tedyapo/tritiled/docs/images/tritiled30_photo.jpg

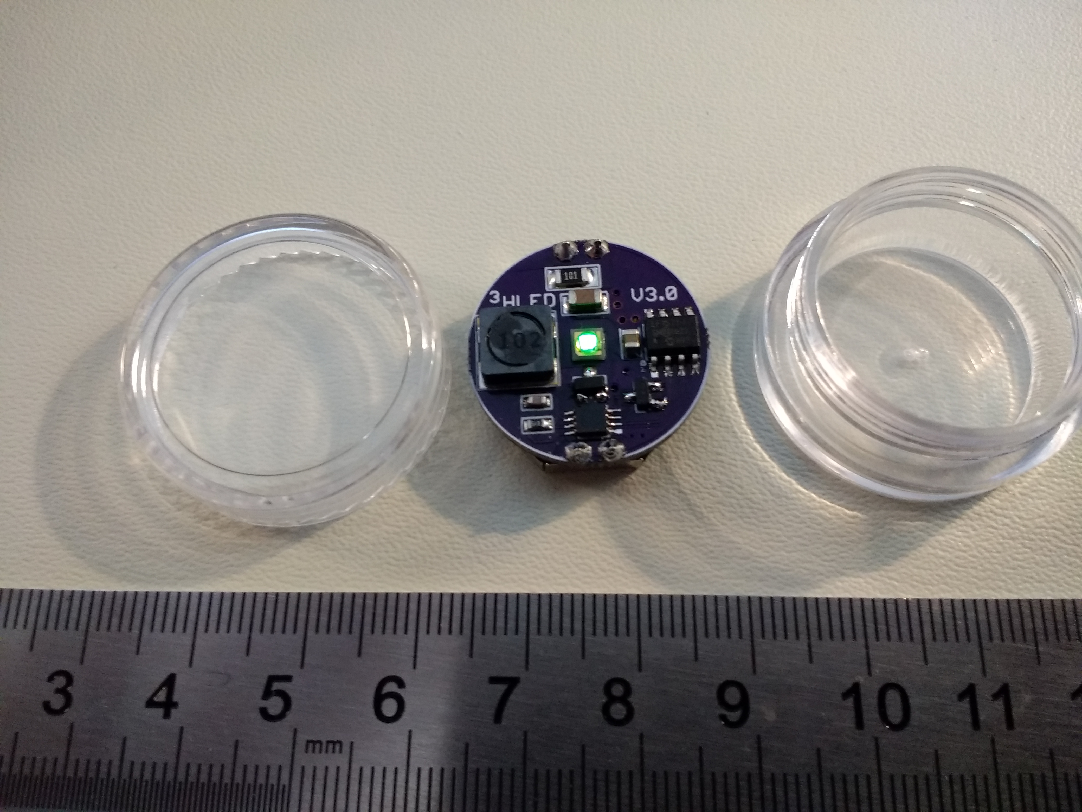
docs/images/tritiled30_photo.jpg
