tedyapo/tritiled/mechanical/tritiled2x_case/tritiled_v22_case.stl

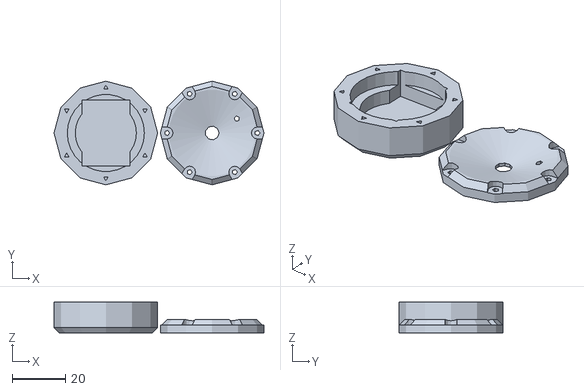
[picture p10: CAD file, 2017-07-12]
mechanical/tritiled2x_case/tritiled_v22_case.stl
79.0 x 39.0 x 11.6
