tedyapo/tritiled/(threads)

Thread 8 (2017-07-27):

Create smaller case for V2.2

tedyapo, 2017-07-27:
Current case design is bulky and required (6) screws.  Make a smaller, more attractive one.

tedyapo, 2018-01-13:
V3.x has a nice case

Closed 2018-01-13.

Thread 10 (2017-08-16):

Power-saving ("off") mode for V2.2

tedyapo, 2017-08-16:
Implement software-only off mode which sleeps until button is pressed to conserve battery; this should be a separate, optional build for those who want such functionality.

tedyapo, 2018-01-13:
power is low enough.  remove battery for real power-off

Closed 2018-01-13.

Thread 33 (2022-09-23):

regenerative snubber

Ozzy33, 2022-09-23:
Hi Ted, awesome project!
Sorry about posting here, at hackaday you didn't seem to respond.
You ever think about a regenerative snubber for the wasted ring energy after LED current has stopped (the drain ringing energy)?
It could add some time to your project? Or are you done with this project?
I will delete this post if your not interested.
TIA!

Thread 36 (2023-10-11):

The interface issue

tedmalonos, 2023-10-11:
The problem in the interface. Just opened the KiCad 7.0 and have this kind of issue, the same problem in every editor.

Don`t know what to do, maube someone knows what to do?

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

Thread 37 (2023-11-10):

How to reduce flickering?

gcormier, 2023-11-10:
I'm trying to get rid of flicker which happens in the lower half of the brightness options for my specific hardware.

I've been trying fairly unsuccessfully to make this happen in software. The closest I've gotten is setting PWM1 phase to 2, which then makes everything really really dim. Which is almost what I want, but then really cuts down on the range I can choose.

Any tips on how to do so would be apprieciated.

tedyapo, 2023-11-10:
i'm assuming this is V2.x hardware? flicker is related to the flash rate. the overall current draw is proportional to the flash rate and the energy per flash; so generally, you get a lower flash rate and more visible flicker with lower overall current draw and extended runtime.

you won't have much luck in software; you can only change the flash rate there.

what you need to do is change the pulse width, which is set by the '123 one-shot. the R and C in the published BoM were chosen to create a pulse width that translates into a current pulse close to the peak LED efficiency. if you reduce the R, you can generate a shorter pulse, which will generate a dimmer and shorter LED pulse. this will allow you to turn up the blink frequency, reducing flicker, while still maintaining a lower current draw.

you will lose a little bit of efficiency here for two reasons. first, you won't be driving the LED near the peak efficiency current. but, take a close look at the LED efficiency curves -- you can cut the LED current in half or more without effecting the efficiency that much. that will let you drive it with more than twice the frequency, reducing flicker. the second efficiency loss is larger, and that is due to the overhead of waking up the PIC and generating the pulse for each flash. if you crank up the frequency to reduce flicker, you'll be losing more efficiency to this overhead. there isn't much you can do about this.

so, my recipe for reducing flicker at lower current draw is to reduce R3 in the V2.x circuit. this will decrease the pulse width and the peak LED current. once this is done, you can increase the pulse rate in software, and the flicker will be reduced. if you want accurate run-time estimates, you'll need to calibrate the current draw.

my suggestion would be to solder a through-hole resistor on the board in place of R3. use long leads for testing. once you find a resistor that gives you the flicker vs current draw you like, you can solder on an SMD resistor permanently. i might try a value of half the initial R3 value as a start. then, play with flicker frequency, either by running the calibration code and python script, or just tweaking the pulse frequency table to your liking. you might want/need to go up or down in resistor value from there.

if you really want to be scientific about it, leave one copy of the circuit as-is, and use it as a comparison reference. at these light levels, it's easy to fool yourself, especially if the changes are somewhat subtle.

i think this is all i got, but i'm going to leave this issue open for a bit because i'm interested to see where you get with this. good luck!

gcormier, 2023-11-10:
Hey Ted! Awesome, thanks so much for the response :) I did not expect one.

As I'm using SMD, I might try to figure out a bodge by solering a resistor on top of the existing one to reduce the resistance. Yay, 0402's! :)

I was going to possibly redesign this at the expense of efficiency. I'll try to take some measurements once I find a very-dim option. Ditching the monostable was what I was eyeing, and I noticed the everled fork with an Attiny13A which can approach 1uA standby. This would be taking a step towards your V2.0 I believe which is just a mosfet controlled directly by a GPIO.

For now, I have 18 of these to play with and fix up in time for Christmas presents. I will definitely report back!

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

gcormier, 2023-11-11:
It works!

I am down to 2.5K on R3. I'm using 1 mH inductor and the Cree XPEBGR-L1-0000-00F02 LED.

I will order some 1K resistors to see how low I can go.

I would love to optimize the BOM slightly, the LED is the biggest contributor to cost. I guess it's the price to pay as the brighter LED's translate to higher efficiency/savings at low power?

My use case is for nighttime to prevent smashing into something in the bedroom. Will make great gifts!

tedyapo, 2023-11-12:
cool. what frequency are you running them at, and what's the current draw? if you can put a scope on the led/inductor, i'd be very interested to see the waveform there. the current pulses must be very short and low

gcormier, 2023-11-12:
Here's my `modes.h`. Basically, your firmware setting 5 became my dimmest setting 10, as I found 4 and under on yours would be blinking.

```
#define N_MODES 10
struct run_time period_table[N_MODES] = {
  {1, (int)(31000./762.124721 + 0.5)},
  {2, (int)(31000./662.124721 + 0.5)},
  {3, (int)(31000./562.124721 + 0.5)},
  {4, (int)(31000./462.124721 + 0.5)},
  {5, (int)(31000./362.124721 + 0.5)},

  {6, (int)(31000./262.124721 + 0.5)},
  {7, (int)(31000./124.768381 + 0.5)},
  {8, (int)(31000./78.982934 + 0.5)},
  {9, (int)(31000./56.090211 + 0.5)},
  {10, (int)(31000./42.354577 + 0.5)},
};
```

I've got a 1K resistor for R3 now and I think that's what I will go with.

gcormier, 2023-11-29:
Here's the scope output

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

gcormier, 2025-05-14:
18 months in and still working off a **CR1225**! My first batch I picked the wrong footprint :)

Just put together 20 more with the proper batteries and updated my repository and instructions - https://github.com/gcormier/kitritiled

They make great little gifts!

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

tedyapo, 2025-05-15:
fantastic! i went the other way with a design: eliminating parts for cost-reduction and making it easier to assemble by hand. it's the 2.x circuit, but using the PWM peripheral wake from sleep for each pulse. it allows a much finer-grained adjustment than the WDT as used in the previous 2.x versions. i haven't documented it yet, of course

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

gcormier, 2025-05-18:
Very cool! Would love to see more if you ever share it!

Thread 38 (2024-06-01):

Universal footprint for LEDs

tort32, 2024-06-01:
Hello. Thank you for the great project.

I have minor PCB optimizations for various LED footprints:
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

This design also suitable for a single-side homebrewed PCBs.

Please see https://oshwlab.com/tort.biz/tritiled
