tedyapo/tritiled/hardware/eagle/V3/tritiled_v31_xpe.brd

## EAGLE design hardware/eagle/V3/tritiled_v31_xpe.brd (2018-01-09)

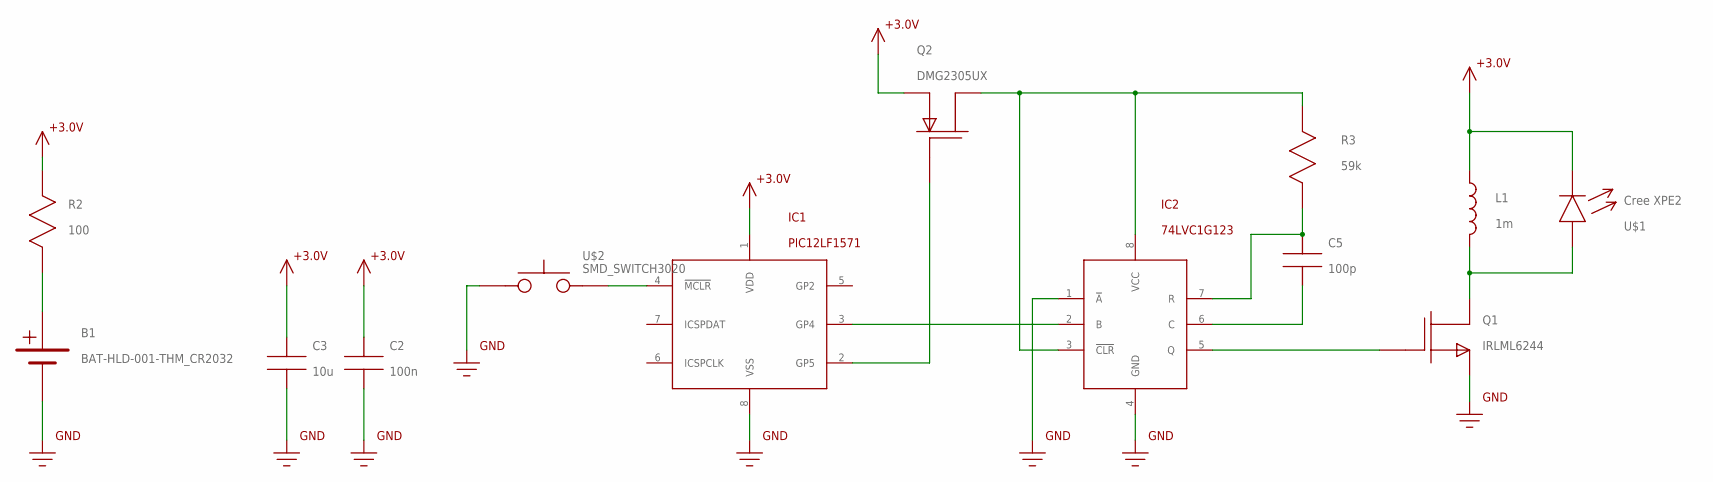
[picture p11: schematic tritiled_v31_xpe.sch]

Parts:
B1: BAT-HLD-001-THM_CR2032; CR2032_BAT-HLD-001-THM
C2: 100n; 0805
C3: 10u; 1206
C5: 100p; C0603
IC1: PIC12LF1571; SOIC8
IC2: 74LVC1G123; SM8
L1: 1m; SRR6028_INDUCTOR
Q1: IRLML6244; SOT-23
Q2: DMG2305UX; SOT-23
R2: 100; R1206
R3: 59k; R0603
U$1: Cree XPE2; CREE_XPE_LED
U$2: SMD_SWITCH3020; SWITCH_3020

Connections:
+3.6V: C2.P$1, C3.P$1, IC1.1 (VDD), L1.P$1 (1), Q2.2 (S), R2.P$1, U$1.C
GND: B1.GND (0V), C2.P$2, C3.P$2, IC1.8 (VSS), IC2.1 (!A!), IC2.4 (GND), Q1.2 (S), U$2.A
unnamed: C5.P$1, IC2.7 (R), R3.P$1
unnamed: IC2.5 (Q), Q1.1 (G)
unnamed: IC1.2 (GP5), Q2.1 (G)
unnamed: IC1.3 (GP4), IC2.2 (B)
unnamed: C5.P$2, IC2.6 (C)
unnamed: IC1.4 (!MCLR!), U$2.B
unnamed: IC2.3 (!CLR!), IC2.8 (VCC), Q2.3 (D), R3.P$2
unnamed: B1.+V@1 (+V), B1.+V@2 (+V), B1.+V@3 (+V), B1.+V@4 (+V), R2.P$2
unnamed: L1.P$2 (2), Q1.3 (D), U$1.A

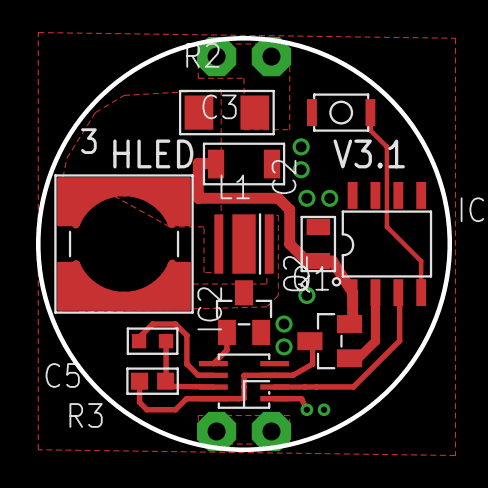
[picture p12: board tritiled_v31_xpe.brd from above]

Board: 2 copper layers, 22.9 x 22.9 mm, 13 parts (1 on the bottom side), 11 nets.
