tedyapo/tritiled/hardware/eagle/V3/tritiled_v30_batt_pcb.brd

## EAGLE design hardware/eagle/V3/tritiled_v30_batt_pcb.brd (2017-12-30)

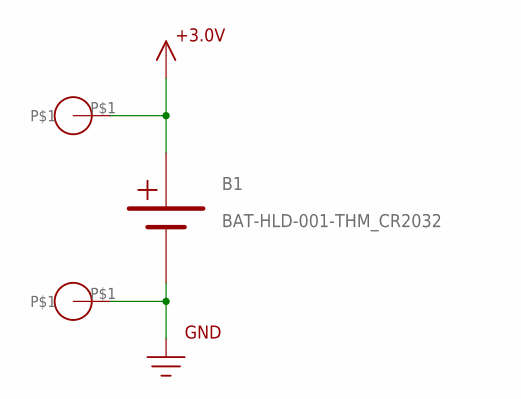
[picture p13: schematic tritiled_v30_batt_pcb.sch]

Parts:
B1: BAT-HLD-001-THM_CR2032; CR2032_BAT-HLD-001-THM
U$1, U$2: HDR_1_PIN

Connections:
+3.6V: B1.+V@1 (+V), B1.+V@2 (+V), B1.+V@3 (+V), B1.+V@4 (+V), U$1.P$1
GND: B1.GND (0V), U$2.P$1

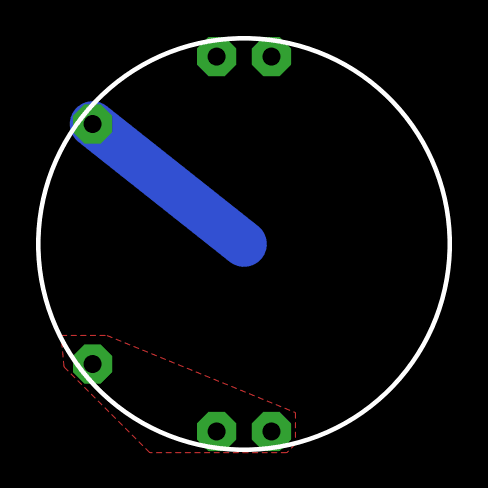
[picture p14: board tritiled_v30_batt_pcb.brd from above]

Board: 2 copper layers, 22.9 x 22.9 mm, 3 parts (1 on the bottom side), 2 nets.
