tedyapo/tritiled/hardware/eagle/V2/tritiled22_5630.brd

## EAGLE design hardware/eagle/V2/tritiled22_5630.brd (2017-08-16, an earlier design)

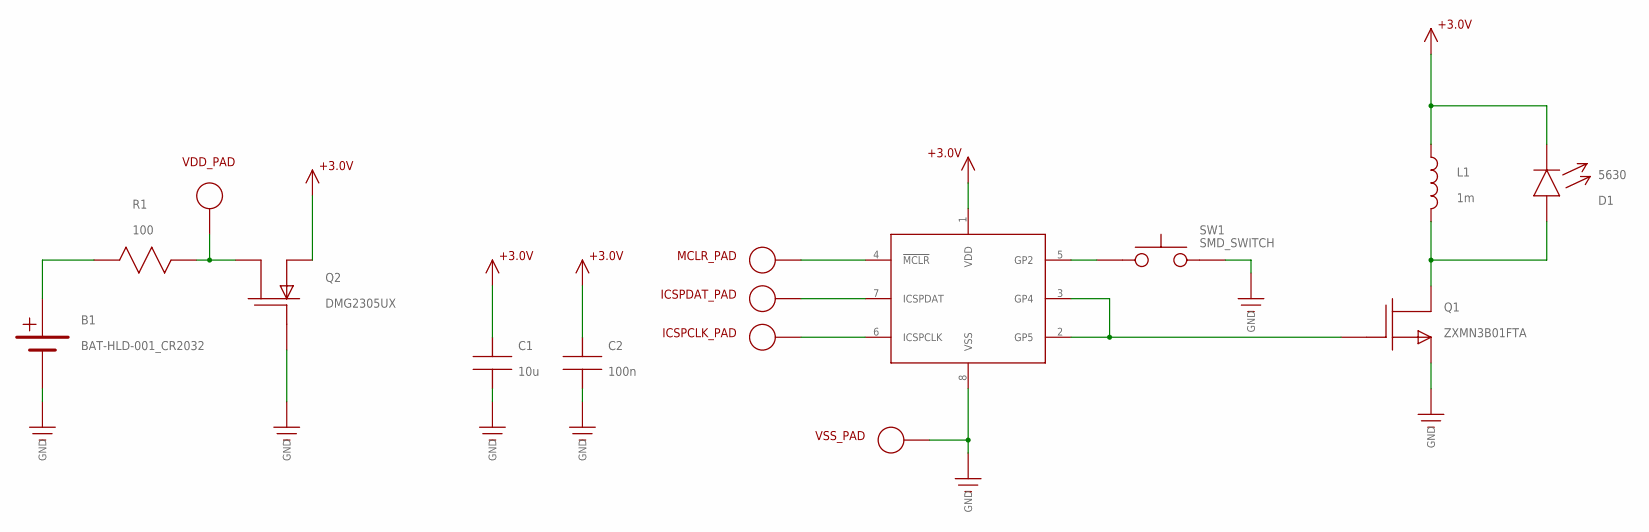
[picture p15: schematic tritiled22_5630.sch]

Parts:
B1: BAT-HLD-001_CR2032; CR2032_BAT-HLD_001
C1: 10u; 1206
C2: 100n; 0805
D1: 5630; LED_5630
ICSPCLK_PAD: ICSP_PAD
ICSPDAT_PAD: ICSP_PAD
L1: 1m; SRR6028_INDUCTOR
MCLR_PAD: ICSP_PAD
Q1: ZXMN3B01FTA; SOT-23
Q2: DMG2305UX; SOT-23
R1: 100; R1206
SW1: SMD_SWITCH
U1: PIC12LF1571; SOIC8
VDD_PAD: ICSP_PAD
VSS_PAD: ICSP_PAD

Connections:
+3.3V: C1.P$1, C2.P$1, D1.C@1 (C), D1.C@2 (C), L1.P$1 (1), Q2.2 (S), U1.1 (VDD)
GND: B1.GND (0V), C1.P$2, C2.P$2, Q1.2 (S), Q2.1 (G), SW1.P$3, SW1.P$4, U1.8 (VSS), VSS_PAD.P$2
unnamed: MCLR_PAD.P$2, U1.4 (!MCLR!)
unnamed: ICSPDAT_PAD.P$2, U1.7 (ICSPDAT)
unnamed: ICSPCLK_PAD.P$2, U1.6 (ICSPCLK)
unnamed: D1.A@1 (A), D1.A@2 (A), L1.P$2 (2), Q1.3 (D)
unnamed: SW1.P$1, SW1.P$2, U1.5 (GP2)
unnamed: Q1.1 (G), U1.2 (GP5), U1.3 (GP4)
VBATT: B1.+V1 (+V), B1.+V2 (+V), R1.P$1
VSAFE: Q2.3 (D), R1.P$2, VDD_PAD.P$2

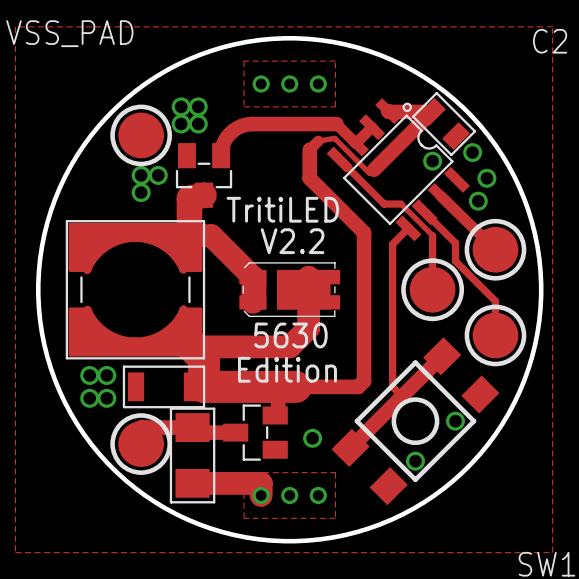
[picture p16: board tritiled22_5630.brd from above]

Board: 2 copper layers, 27.9 x 27.9 mm, 15 parts (1 on the bottom side), 10 nets.
