tedyapo/tritiled/hardware/eagle/V2/tritiled22_cr2477.brd

## EAGLE design hardware/eagle/V2/tritiled22_cr2477.brd (2017-12-18, an earlier design)

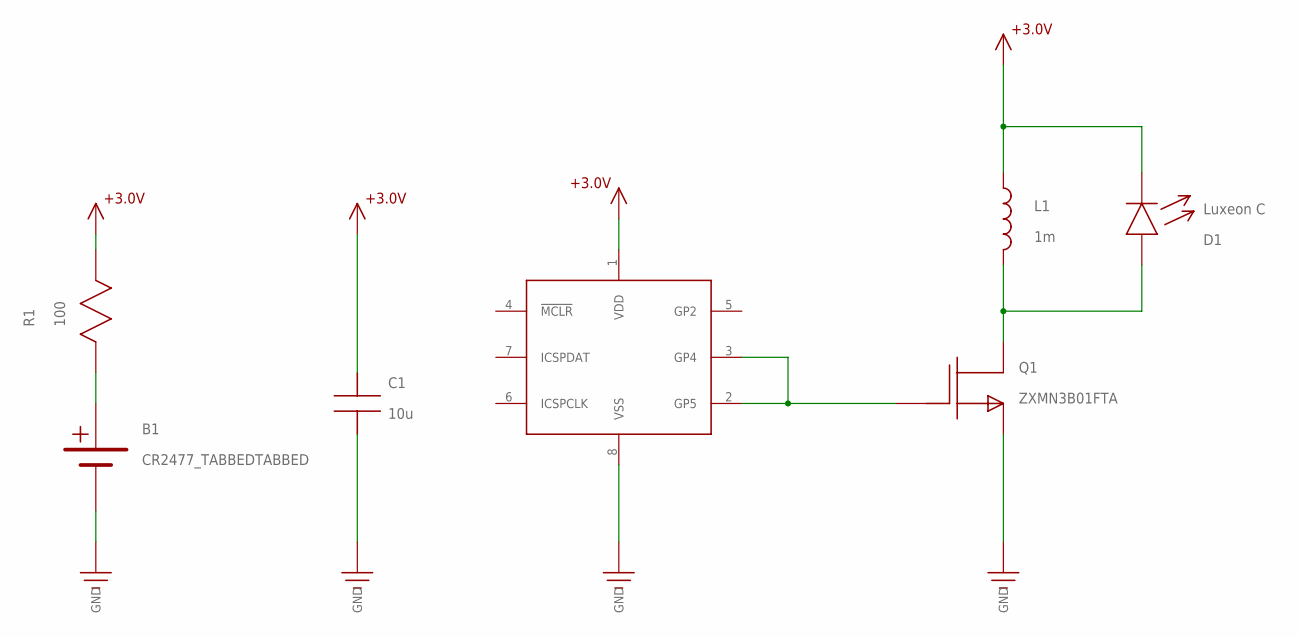
[picture p17: schematic tritiled22_cr2477.sch]

Parts:
B1: CR2477_TABBEDTABBED; CR2477_TABBED
C1: 10u; 1206
D1: Luxeon C; LUXEON_C
L1: 1m; SRR6028_INDUCTOR
Q1: ZXMN3B01FTA; SOT-23
R1: 100; R1206
U1: PIC12LF1571; SOIC8

Connections:
+3.3V: C1.P$1, D1.C, L1.P$1 (1), R1.P$2, U1.1 (VDD)
GND: B1.GND (0V), C1.P$2, Q1.2 (S), U1.8 (VSS)
unnamed: D1.A, L1.P$2 (2), Q1.3 (D)
unnamed: Q1.1 (G), U1.2 (GP5), U1.3 (GP4)
VBATT: B1.+3V (+V), R1.P$1

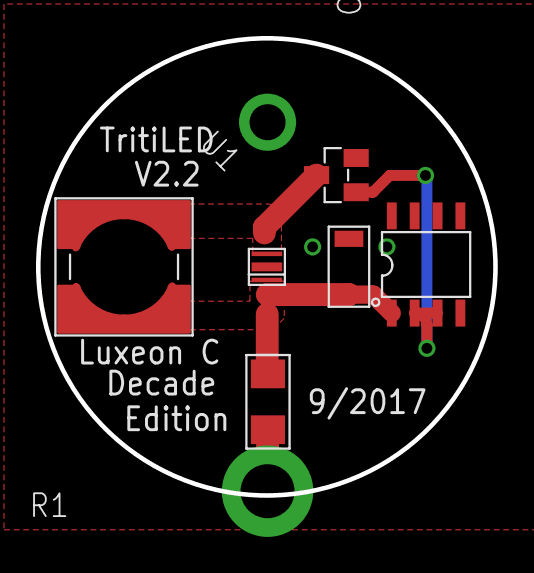
[picture p18: board tritiled22_cr2477.brd from above]

Board: 2 copper layers, 25.4 x 25.4 mm, 7 parts (1 on the bottom side), 5 nets.
