tedyapo/tritiled/hardware/eagle/V2/tritiled_module.brd

## EAGLE design hardware/eagle/V2/tritiled_module.brd (2017-12-18, an earlier design)

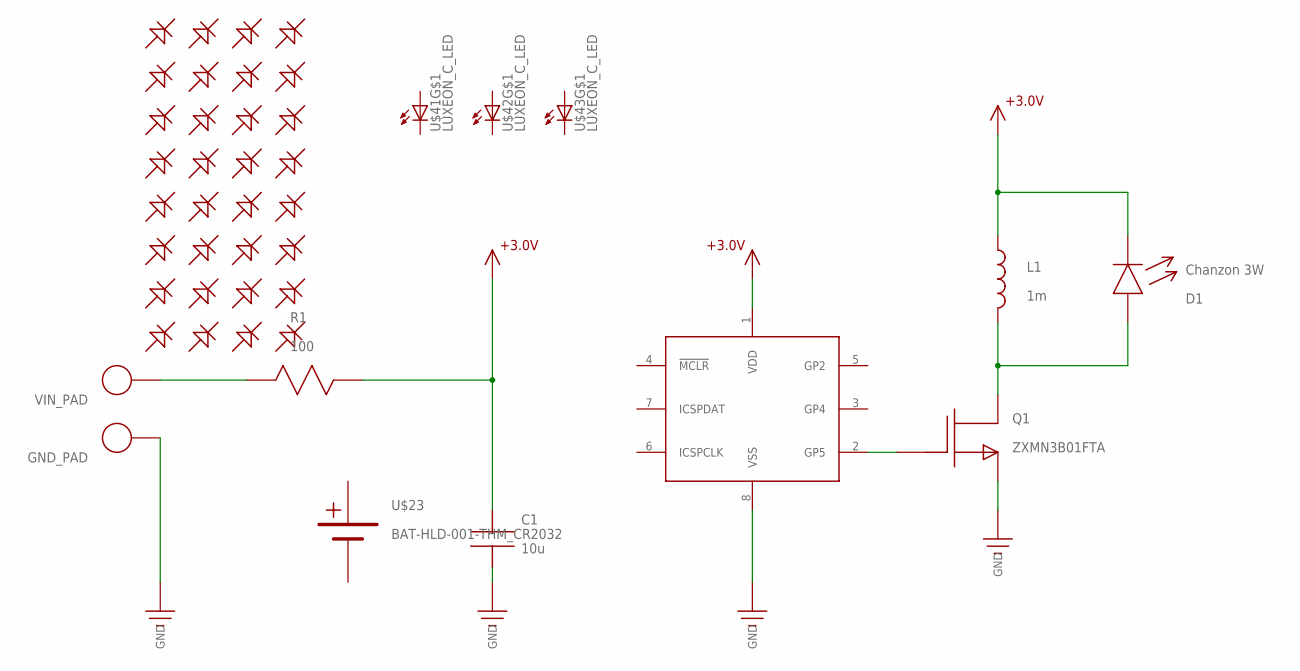
[picture p19: schematic tritiled_module.sch]

Parts:
C1: 10u; 1206
D1: Chanzon 3W; LED_3W
GND_PAD: ICSP_PAD
L1: 1m; SRR6028_INDUCTOR
Q1: ZXMN3B01FTA; SOT-23
R1: 100; R1206
U1: PIC12LF1571; SOIC8
U$1, U$5, U$6, U$7, U$8, U$9, U$10, U$12, U$16, U$17, U$18, U$19, U$20, U$21, U$22, U$24, U$25, U$26, U$27, U$28, U$29, U$30, U$31, U$32, U$33, U$34, U$35, U$36, U$37, U$38, U$39, U$40: LED_0603
U$23: BAT-HLD-001-THM_CR2032; CR2032_BAT-HLD-001-THM
U$41, U$42, U$43: LUXEON_C_LED; LUXEON_C
VIN_PAD: ICSP_PAD

Connections:
0V: U$23.GND (0V)
+3V: C1.P$1, D1.C, L1.P$1 (1), R1.P$2, U1.1 (VDD)
+V: U$23.+V@1 (+V), U$23.+V@2 (+V), U$23.+V@3 (+V), U$23.+V@4 (+V)
GND: C1.P$2, GND_PAD.P$2, Q1.2 (S), U1.8 (VSS)
unnamed: R1.P$1, VIN_PAD.P$2
unnamed: D1.A, L1.P$2 (2), Q1.3 (D)
unnamed: Q1.1 (G), U1.2 (GP5)

Board: 2 copper layers, 44 parts (4 on the bottom side), 6 nets, no tracks yet.
