tedyapo/tritiled/hardware/eagle/V2/tritiled2x_programmer.brd

## EAGLE design hardware/eagle/V2/tritiled2x_programmer.brd (2017-07-12, an earlier design)

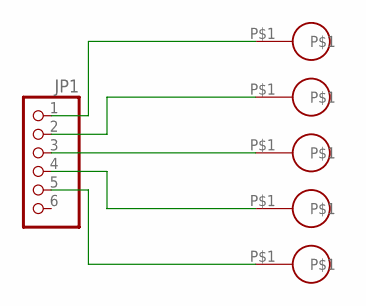
[picture p20: schematic tritiled2x_programmer.sch]

Parts:
JP1: PINHD-1X6; 1X06
U$1, U$2, U$3, U$4, U$5: SPRING_PIN

Connections:
ICSPCLK: JP1.5, U$5.P$1
ICSPDAT: JP1.4, U$4.P$1
VDD: JP1.2, U$2.P$1
VPP: JP1.1, U$1.P$1
VSS: JP1.3, U$3.P$1

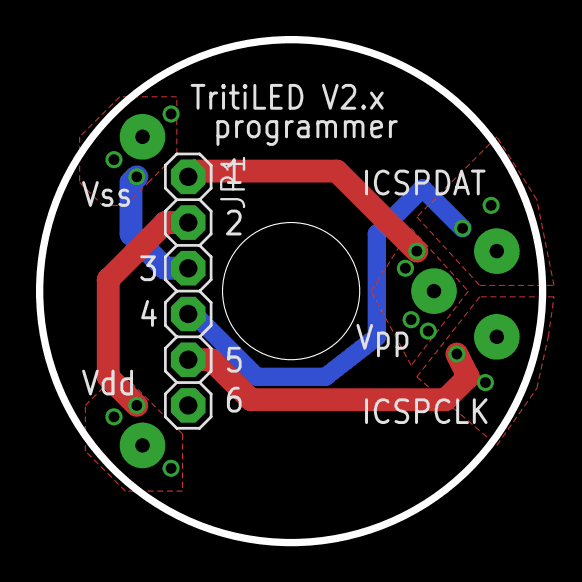
[picture p21: board tritiled2x_programmer.brd from above]

Board: 2 copper layers, 27.9 x 27.9 mm, 6 parts (0 on the bottom side), 5 nets.
