tedyapo/tritiled/software/tritiled30/src/modes.h

#define N_MODES 10
struct run_time period_table[N_MODES] = {
  {1, (int)(31000./262.124721 + 0.5)},
  {2, (int)(31000./124.768381 + 0.5)},
  {3, (int)(31000./78.982934 + 0.5)},
  {4, (int)(31000./56.090211 + 0.5)},
  {5, (int)(31000./42.354577 + 0.5)},
  {6, (int)(31000./33.197487 + 0.5)},
  {7, (int)(31000./26.656709 + 0.5)},
  {8, (int)(31000./21.751126 + 0.5)},
  {9, (int)(31000./17.935672 + 0.5)},
  {10, (int)(31000./14.883309 + 0.5)},
};
