tedyapo/tritiled/(commit log)

2017-07-12 initial commit for v22
    [tritiled22.DRL, tritiled22.GBL, tritiled22.GBO, tritiled22.GBS, tritiled22.GKO, tritiled22.GTL, tritiled22.GTO, tritiled22.GTS]
2017-07-12 added design files for 3D printed case for V2.x series boards
    [tritiled_v22_case.scad, tritiled_v22_case.stl]
2017-07-13 added names and values to schematic and PCB
    [tritiled22.brd, tritiled22.sch]
2017-07-13 added BOM for v2.2, library tweaks
2017-07-16 modified library and tritiled22 PCB for solder stencil generation
    [tritiled22.brd, tritiled22.sch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]
2017-07-27 changed default pulses from 1 to 2 for 2.5 year run-time (was 3+ years)
    [tritiled22.DRL, tritiled22.GBL, tritiled22.GBO, tritiled22.GBS, tritiled22.GKO, tritiled22.GTL, tritiled22.GTO, tritiled22.GTS]
2017-08-16 Added new LED eiditons: 5630, Luxeon C, Luxeon Z fixed inconsistent C2 value: now should be 100n everywhere
    [tritiled22_5630.DRL, tritiled22_5630.GBL, tritiled22_5630.GBO, tritiled22_5630.GBS, tritiled22_5630.GKO, tritiled22_5630.GTL, tritiled22_5630.GTO, tritiled22_5630.GTP]
2017-08-17 added Cree XP-E(2) edition
    [tritiled22_xpe.DRL, tritiled22_xpe.GBL, tritiled22_xpe.GBO, tritiled22_xpe.GBS, tritiled22_xpe.GKO, tritiled22_xpe.GTL, tritiled22_xpe.GTO, tritiled22_xpe.GTP]
2017-08-20 added PCBs for CR2354-based versions
    [tritiled22_cr2354_lux_c.DRL, tritiled22_cr2354_lux_c.GBL, tritiled22_cr2354_lux_c.GBO, tritiled22_cr2354_lux_c.GBS, tritiled22_cr2354_lux_c.GKO, tritiled22_cr2354_lux_c.GTL, tritiled22_cr2354_lux_c.GTO, tritiled22_cr2354_lux_c.GTP]
2017-08-28 added new reversed editions
    [tritiled22_cr2354_lux_c_reverse.DRL, tritiled22_cr2354_lux_c_reverse.GBL, tritiled22_cr2354_lux_c_reverse.GBO, tritiled22_cr2354_lux_c_reverse.GBS, tritiled22_cr2354_lux_c_reverse.GKO, tritiled22_cr2354_lux_c_reverse.GTL, tritiled22_cr2354_lux_c_reverse.GTO, tritiled22_cr2354_lux_c_reverse.GTP]
2017-12-18 added V3.0; re-arranged directory structure
    [tritiled22.brd, tritiled22.sch, tritiled22_5630.brd, tritiled22_5630.sch, tritiled22_cr2354.brd, tritiled22_cr2354.sch, tritiled22_cr2354_lux_c.brd, tritiled22_cr2354_lux_c.sch]
2017-12-23 Fixed V3.0 board (74LVC1G123 A_bar now pulled low)
    [tritiled_v30.GBL, tritiled_v30.GBO, tritiled_v30.GBS, tritiled_v30.GKO, tritiled_v30.GTL, tritiled_v30.GTO, tritiled_v30.GTP, tritiled_v30.GTS]
2017-12-27 Smaller v30 boards to got 5g (possibly 3g) polystyrene jars with new LED types
    [tritiled_v30_lux_c.GBL, tritiled_v30_lux_c.GBO, tritiled_v30_lux_c.GBS, tritiled_v30_lux_c.GKO, tritiled_v30_lux_c.GTL, tritiled_v30_lux_c.GTO, tritiled_v30_lux_c.GTP, tritiled_v30_lux_c.GTS]
2017-12-30 added luxeon_c V30 boards (normal plus reverse)
    [tritiled_v30_batt_pcb.GBL, tritiled_v30_batt_pcb.GBO, tritiled_v30_batt_pcb.GBS, tritiled_v30_batt_pcb.GKO, tritiled_v30_batt_pcb.GTL, tritiled_v30_batt_pcb.GTO, tritiled_v30_batt_pcb.GTP, tritiled_v30_batt_pcb.GTS]
2018-01-03 updated files for initial V3.0 release
    [tritiled_v30_oslon.brd, tritiled_v30_oslon.sch]
2018-01-04 correct values for R3
    [tritiled_v30_lux_c.brd, tritiled_v30_lux_c.sch, tritiled_v30_xpe.brd, tritiled_v30_xpe.sch]
2018-01-06 added calibrated values to V3.0 C-code
2018-01-07 fixe bug with writing HEF too often
    [tritiled_v30_selectable_runtime.c]
2018-01-09 Added PCB designs for V31 - includes mode switch
    [tritiled_v31_oslon.GBL, tritiled_v31_oslon.GBO, tritiled_v31_oslon.GBS, tritiled_v31_oslon.GKO, tritiled_v31_oslon.GTL, tritiled_v31_oslon.GTO, tritiled_v31_oslon.GTP, tritiled_v31_oslon.GTS]
2018-01-09 V3.1 silkscreen says "V3.1"
    [tritiled_v31_oslon.brd, tritiled_v31_xpe.brd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]
2018-01-13 added preview of brightness to power-on configuration UI
2018-01-23 added code for V3.x calibration
